sagebrushchurch/kiosk-speaker-mount/output/assembly_with_references.step

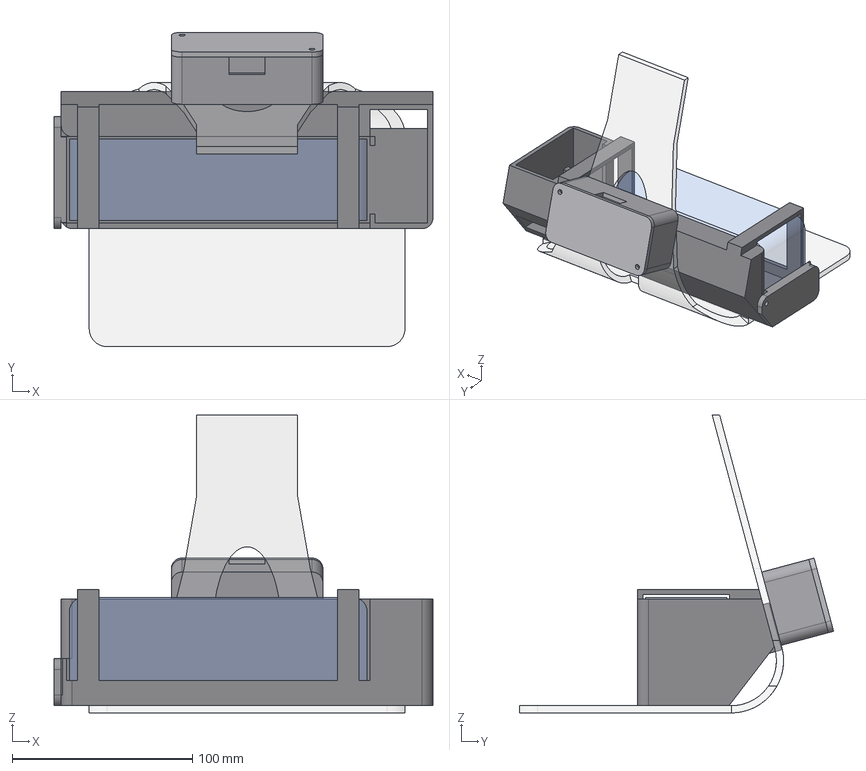
[picture p11: CAD file, 2026-11-01]
output/assembly_with_references.step
210.0 x 174.2 x 165.0 mm
cradle
end_gate
rear_box
rear_lid
ref_soundcore2
ref_stand
