sagebrushchurch/kiosk-speaker-mount/output/rear_lid.step

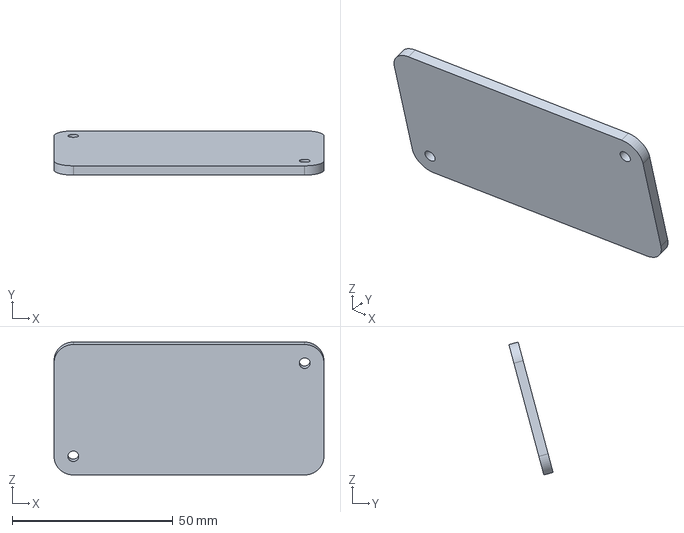
[picture p12: CAD file, 2026-11-01]
output/rear_lid.step
84.0 x 13.8 x 41.3 mm
