sagebrushchurch/kiosk-speaker-mount/output/rear_box.step

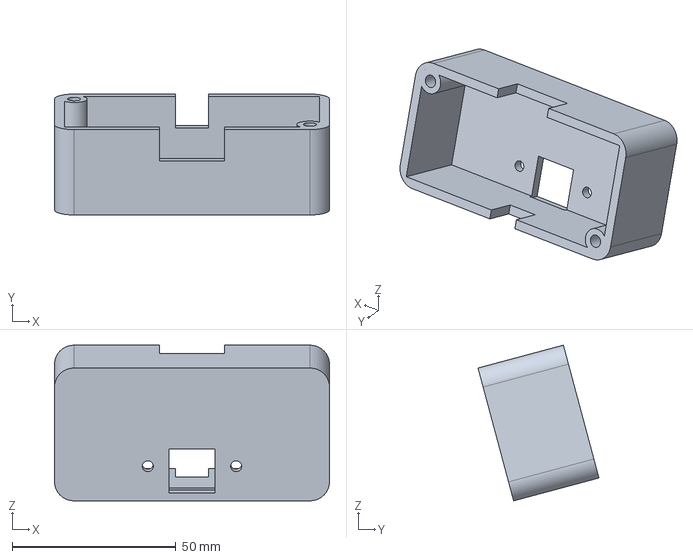
[picture p13: CAD file, 2026-11-01]
output/rear_box.step
84.0 x 37.0 x 47.6 mm
