sagebrushchurch/kiosk-speaker-mount/output/end_gate.step

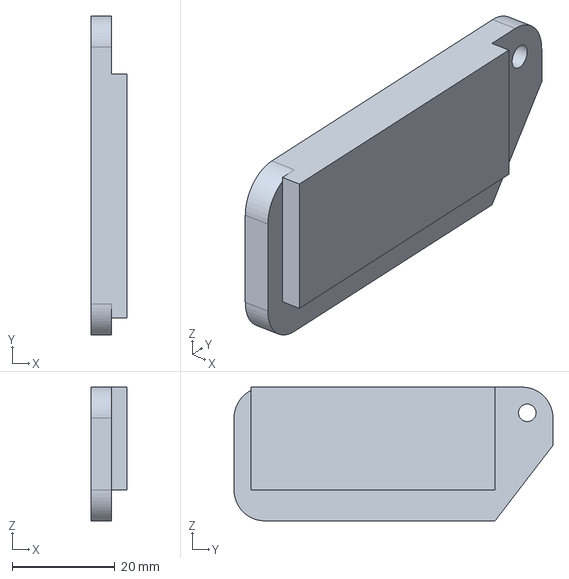
[picture p14: CAD file, 2026-11-01]
output/end_gate.step
7.00 x 62.0 x 26.0 mm
