sagebrushchurch/kiosk-speaker-mount/output/cradle.step

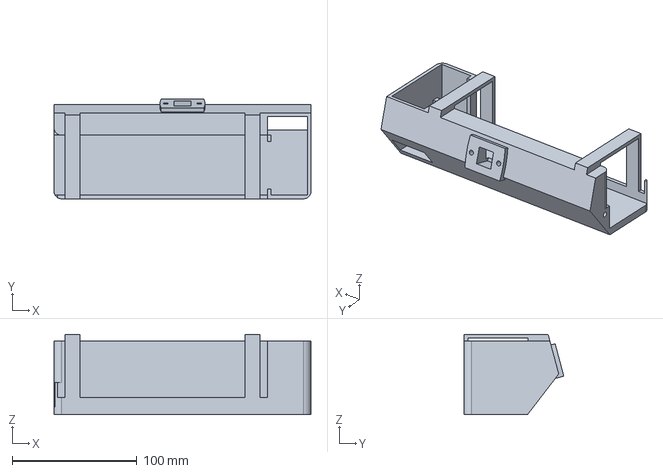
[picture p15: CAD file, 2026-11-01]
output/cradle.step
206.0 x 79.9 x 64.5 mm
