sagebrushchurch/kiosk-speaker-mount/(list of files, cad)

Other CAD files:
output/cradle.stl
output/end_gate.stl
output/rear_box.stl
output/rear_lid.stl
