sagebrushchurch/kiosk-speaker-mount/(commit log)

2026-11-01 Add parametric kiosk speaker plinth (CadQuery) with STEP/STL exports
    Hollow plinth for the AboveTEK countertop tablet stand with a front
    cradle for the Anker Soundcore 2, an open port bay for always-connected
    USB/AUX cables, a hidden cable cavity, and a screw-on bottom cover.
    [assembly_with_references.step, bottom_cover.step, bottom_cover.stl, plinth.step, plinth.stl]
2026-11-01 Add render/live-view tooling, session notes, and VS Code workspace setup
    - render.py: off-screen VTK renders (9 views incl. exploded and sections) to renders/
    - view.py: live 3D view via OCP CAD Viewer, with a clear message if the viewer is closed
    - AGENTS.md (agent context/conventions) and SESSION_NOTES.md (decisions, history, open items)
    - .vscode settings (repo .venv interpreter) and recommended extensions
    - README: preview section with render gallery, project file table
    - requirements: add ocp_vscode
    [assembly_with_references.step, bottom_cover.step, plinth.step]
2026-11-01 Redesign as clamp-on cradle through the stand's oval cutout
    Replace the full-under-stand plinth and bottom cover with a compact
    speaker cradle that rests on the stand's base plate in front of the
    upright. A tongue passes through the oval cutout and is clamped to a
    rear box on the staff side with M3 security Torx screws; the box hides
    the USB splitter and has a screw-on lid.
    - Reference stand modelled as one bent steel sheet (from owner photos)
    - check() now runs on every build: overlaps, hole alignment, tablet clearance
    - New renders, live viewer, README, AGENTS.md and session notes updated
    [assembly_with_references.step, bottom_cover.step, bottom_cover.stl, cradle.step, cradle.stl, plinth.step, plinth.stl, rear_box.step]
2026-11-01 Lean the upright to 75°, retain the speaker, hollow the back
    - UPRIGHT_ANGLE (75°): clamp parts built in a plate frame and tilted
    - Two top bars, end-stop fins, and a screwed end gate (new part);
    the speaker slides in from the customer's left. Strap slots removed.
    - Sealed cavities in the back section (310 -> 212 cm^3)
    - check() covers the gate and speaker retention; new 10_loading render
    - README, AGENTS.md, SESSION_NOTES.md updated
    [assembly_with_references.step, cradle.step, cradle.stl, end_gate.step, end_gate.stl, rear_box.step, rear_box.stl, rear_lid.step]
